Jir8taiwan/ST170_ext.control_IMRC/bypass IMRC detection without usage_2.jpg

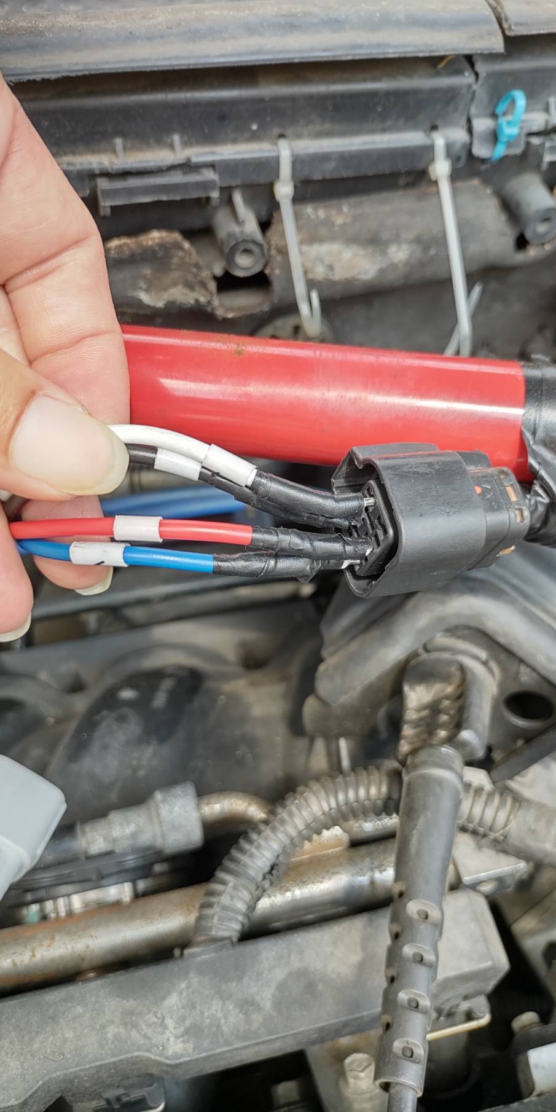
bypass IMRC detection without usage_2.jpg
