Jir8taiwan/ST170_ext.control_IMRC/[planB]_IMRCmod_and_DirectDrive_Motor/IMRC internal modify_2026-06-15.jpg

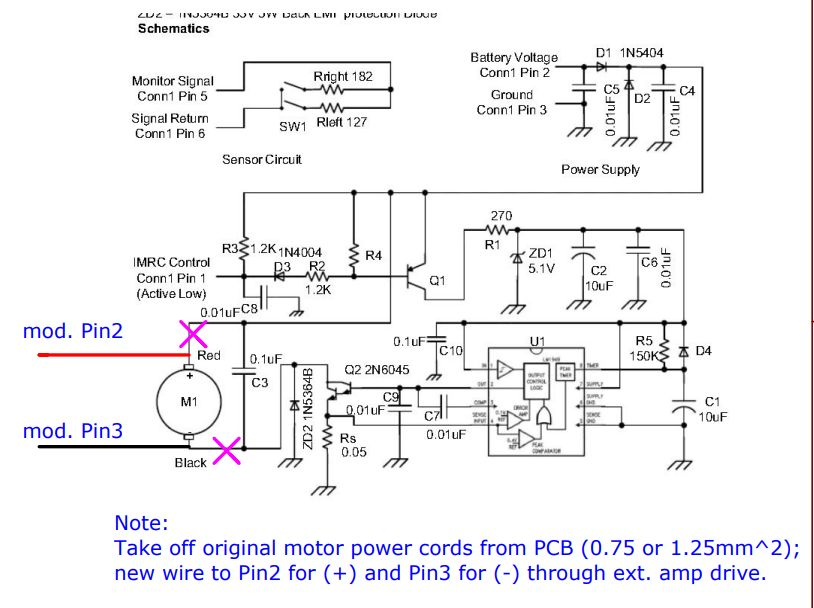
[planB]_IMRCmod_and_DirectDrive_Motor/IMRC internal modify_2026-06-15.jpg
