Jir8taiwan/ST170_ext.control_IMRC/[planB]_IMRCmod_and_DirectDrive_Motor/IMRC_75R硬體開關迴路變電晶體開關迴路_260708.jpg

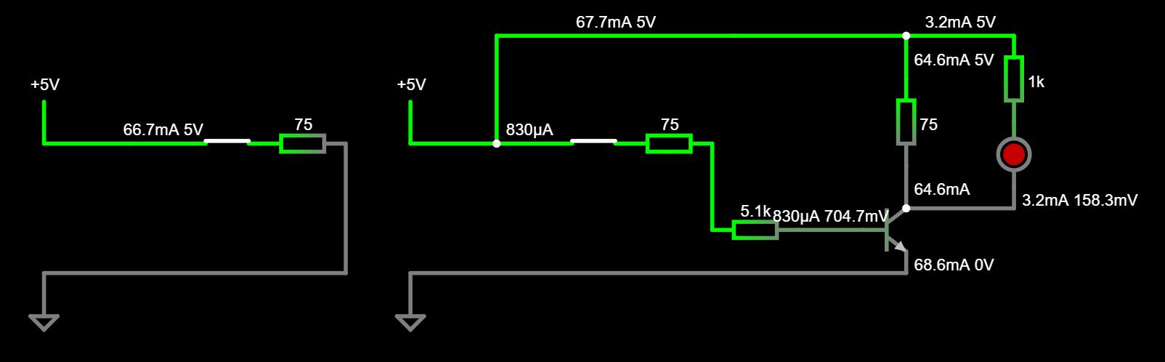
[planB]_IMRCmod_and_DirectDrive_Motor/IMRC_75R硬體開關迴路變電晶體開關迴路_260708.jpg
