Jir8taiwan/ST170_ext.control_IMRC/[planB]_IMRCmod_and_DirectDrive_Motor/IMRC_DirectDrive_by CVCC power source and 5V relay_260105_.jpg

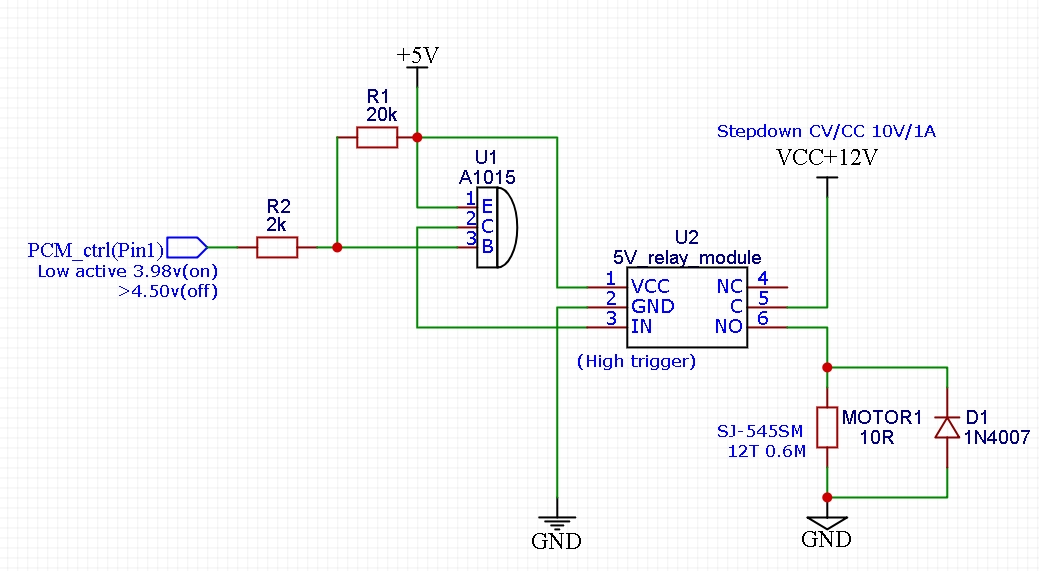
[planB]_IMRCmod_and_DirectDrive_Motor/IMRC_DirectDrive_by CVCC power source and 5V relay_260105_.jpg
