Jir8taiwan/ST170_ext.control_IMRC/[planB]_IMRCmod_and_DirectDrive_Motor/Schematic_IMRCmod_DirectDrive_Motor_2026-07-09.pdf

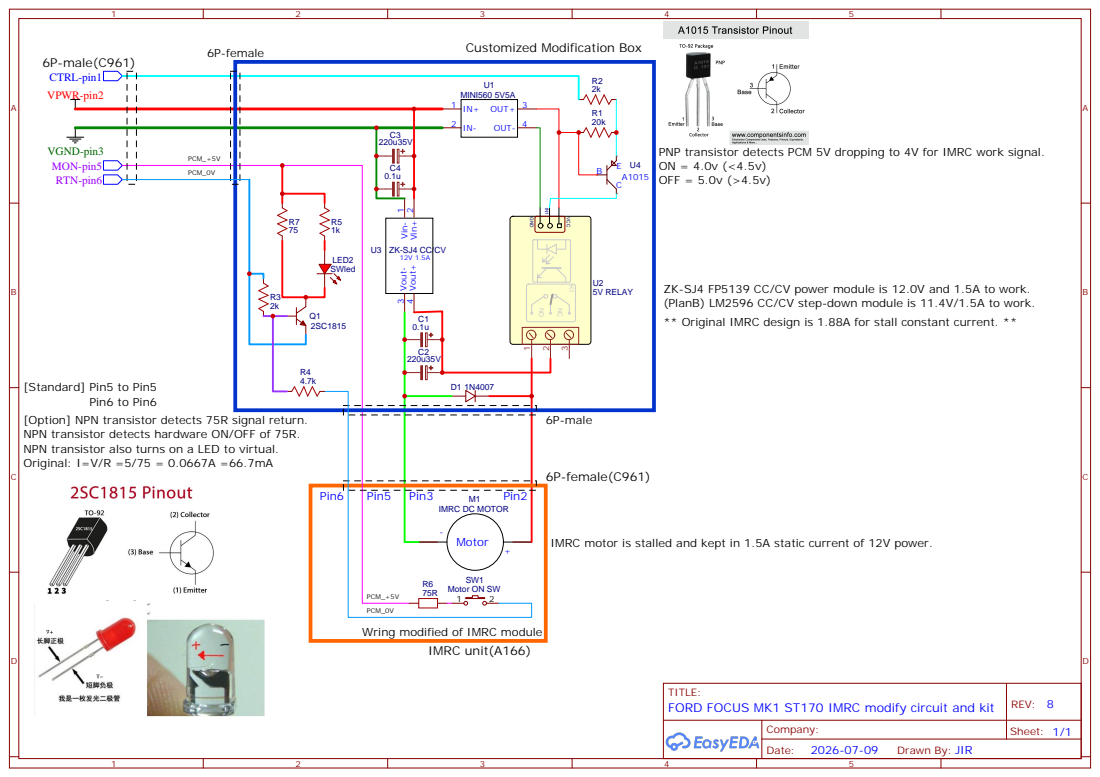
[picture p7: page 1]

U3 ZK-SJ4 CC/CV Vin+

ZK-SJ4 FP5139 CC/CV power module is 12.0V and 1.5A to work.
(PlanB) LM2596 CC/CV step-down module is 11.4V/1.5A to work.
** Original IMRC design is 1.88A for stall constant current. **

[Option] NPN transistor detects 75R signal return.
NPN transistor detects hardware ON/OFF of 75R.
NPN transistor also turns on a LED to virtual.
Original: I=V/R =5/75 = 0.0667A =66.7mA

IMRC motor is stalled and kept in 1.5A static current of 12V power.
