Jir8taiwan/ST170_ext.control_IMRC/[planA]_ArduinoIMRC_DCmotorControl/Schematic_ST170_ext.control_IMRC diagram_2026-06-26.pdf

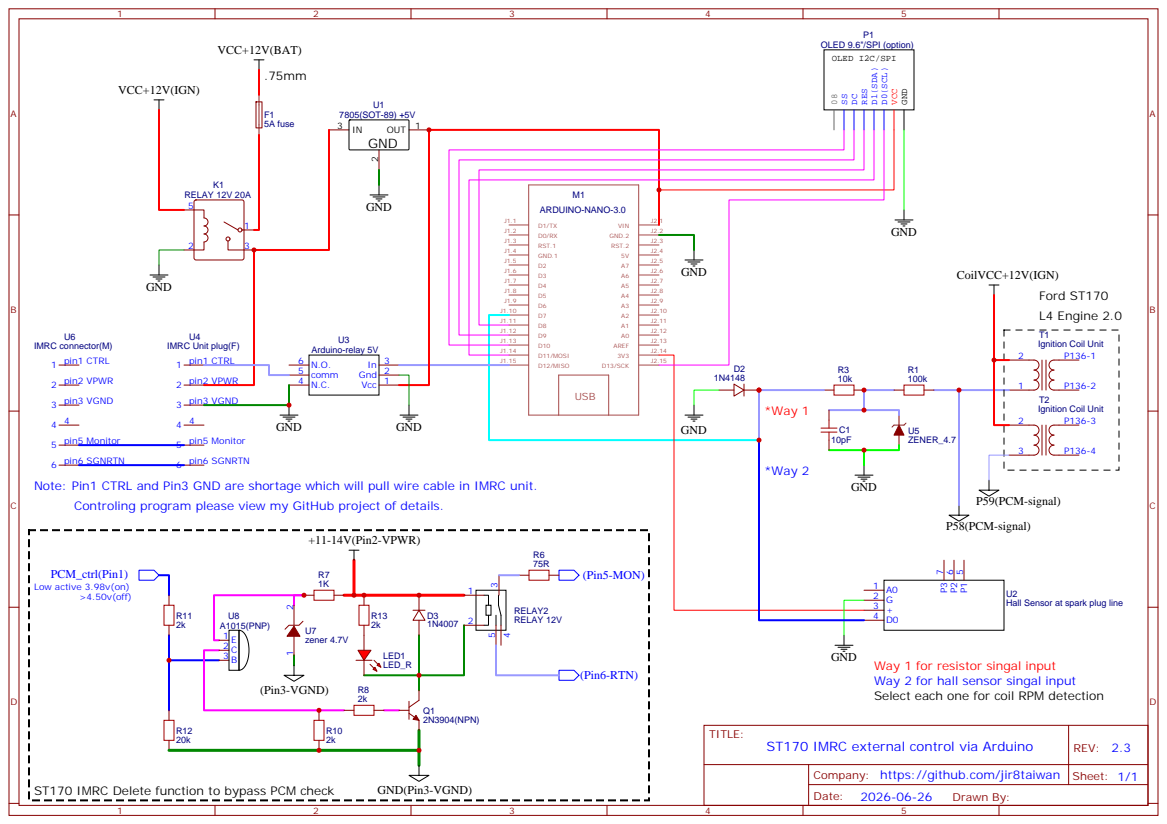
[picture p8: page 1]

Hall Sensor at spark plug line

GND
Way 1 for resistor singal input
Way 2 for hall sensor singal input
Select each one for coil RPM detection

Company: https://github.com/jir8taiwan

ST170 IMRC Delete function to bypass PCM check
