Jir8taiwan/ST170_ext.control_IMRC/[planB]_IMRCmod_and_DirectDrive_Motor/Schematic_IMRCmod_DirectDrive_Motor_2026-06-17.pdf

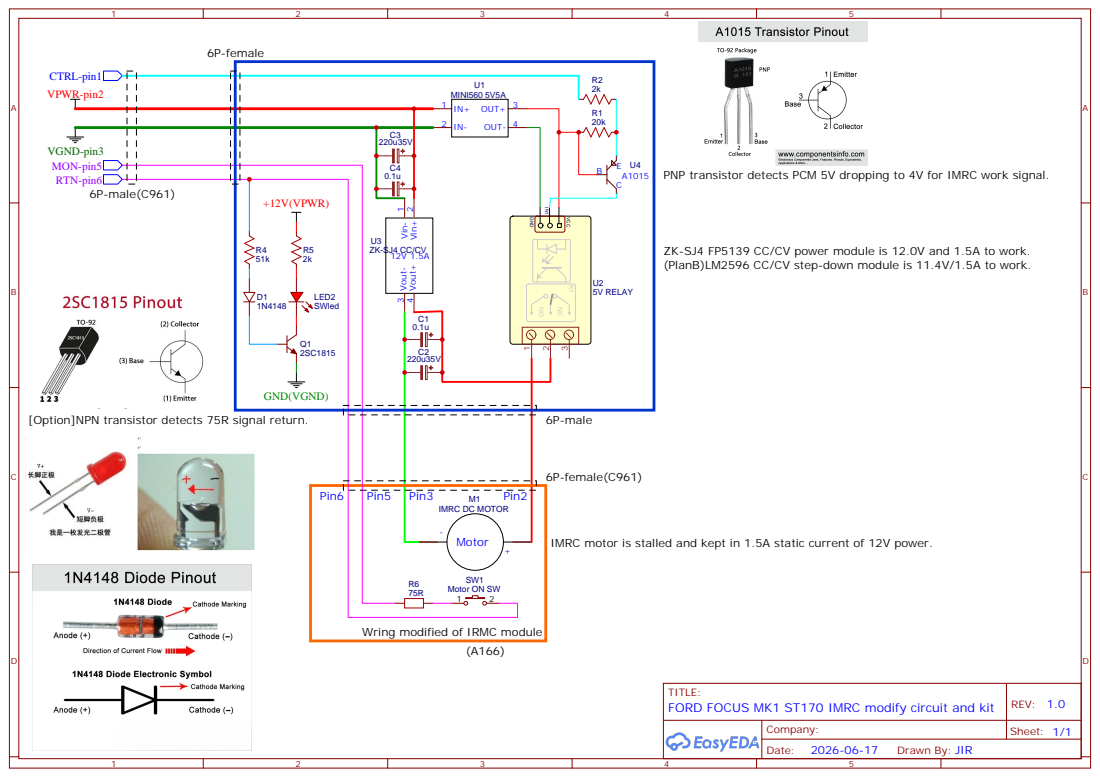
[picture p9: page 1]

PNP transistor detects PCM 5V dropping to 4V for IMRC work signal.

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

[Option]NPN transistor detects 75R signal return.

IMRC motor is stalled and kept in 1.5A static current of 12V power.

Wring modified of IRMC module
