Jir8taiwan/ST170_ext.control_IMRC/[planA]_ArduinoIMRC_DCmotorControl/Schematic_ST170_ext.control_IMRC diagram_251113.pdf

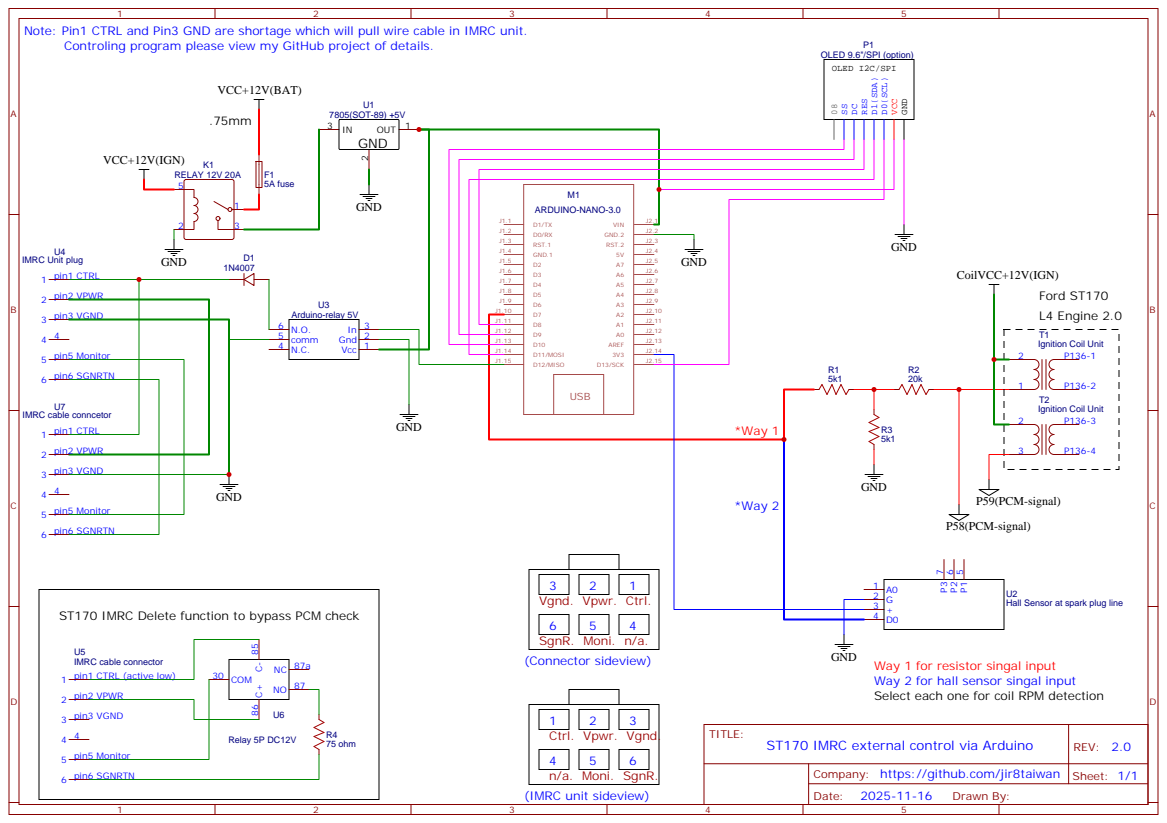
[picture p10: page 1]

Note: Pin1 CTRL and Pin3 GND are shortage which will pull wire cable in IMRC unit.
Controling program please view my GitHub project of details.

Hall Sensor at spark plug line

ST170 IMRC Delete function to bypass PCM check

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

Company: https://github.com/jir8taiwan
