Jir8taiwan/ST170_ext.control_IMRC/[planA]_ArduinoIMRC_DCmotorControl/ArduinoIMRC_DCmotorControl_2025-12-08.pdf

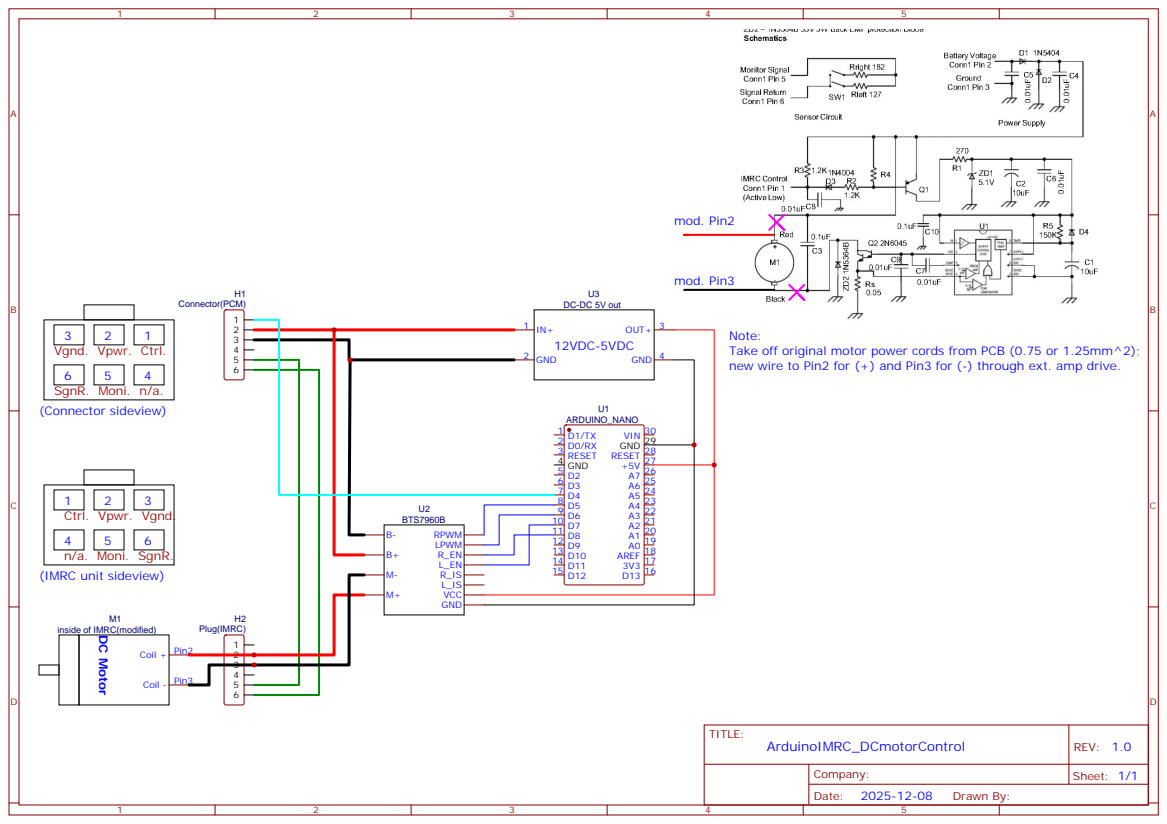
[picture p11: page 1]

Note:
Take off original motor power cords from PCB (0.75 or 1.25mm^2);
new wire to Pin2 for (+) and Pin3 for (-) through ext. amp drive.

inside of IMRC(modified)
