Jir8taiwan/ST170_ext.control_IMRC/Schematic_IMRC_RelayModule_trigger_2026-06-24.pdf

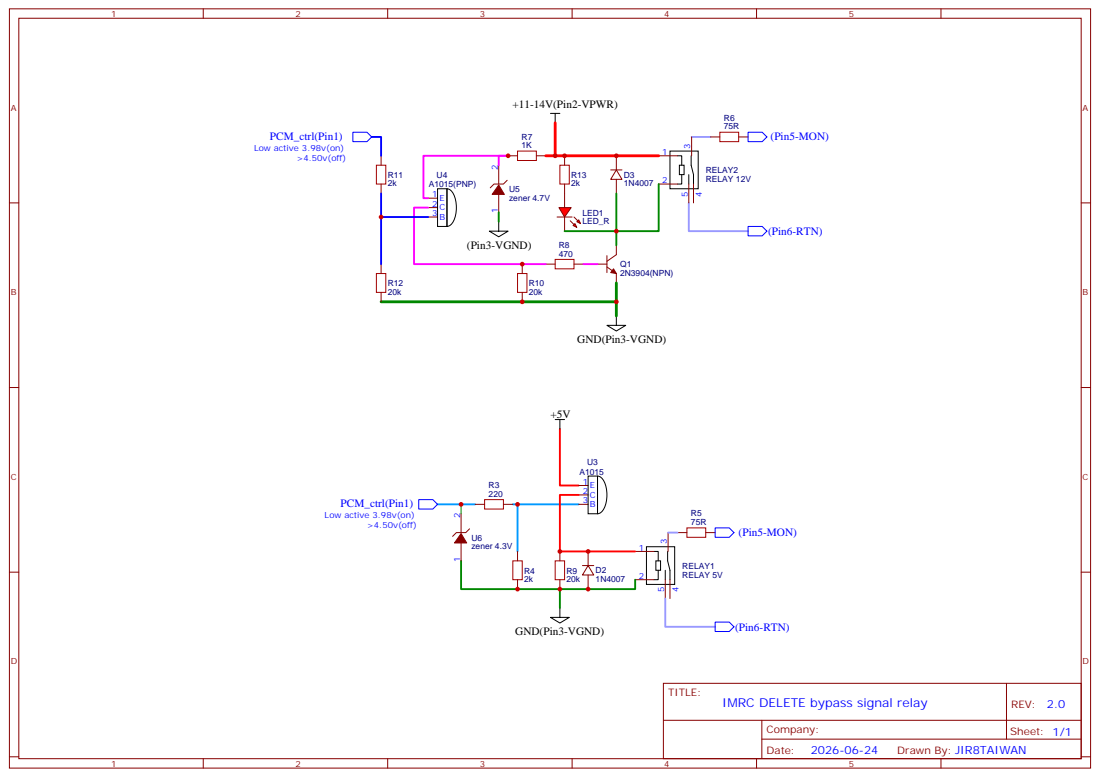
[picture p12: page 1]
