Jir8taiwan/ST170_ext.control_IMRC/Schematic_IMRC_RelayModule_trigger_2026-06-23.pdf

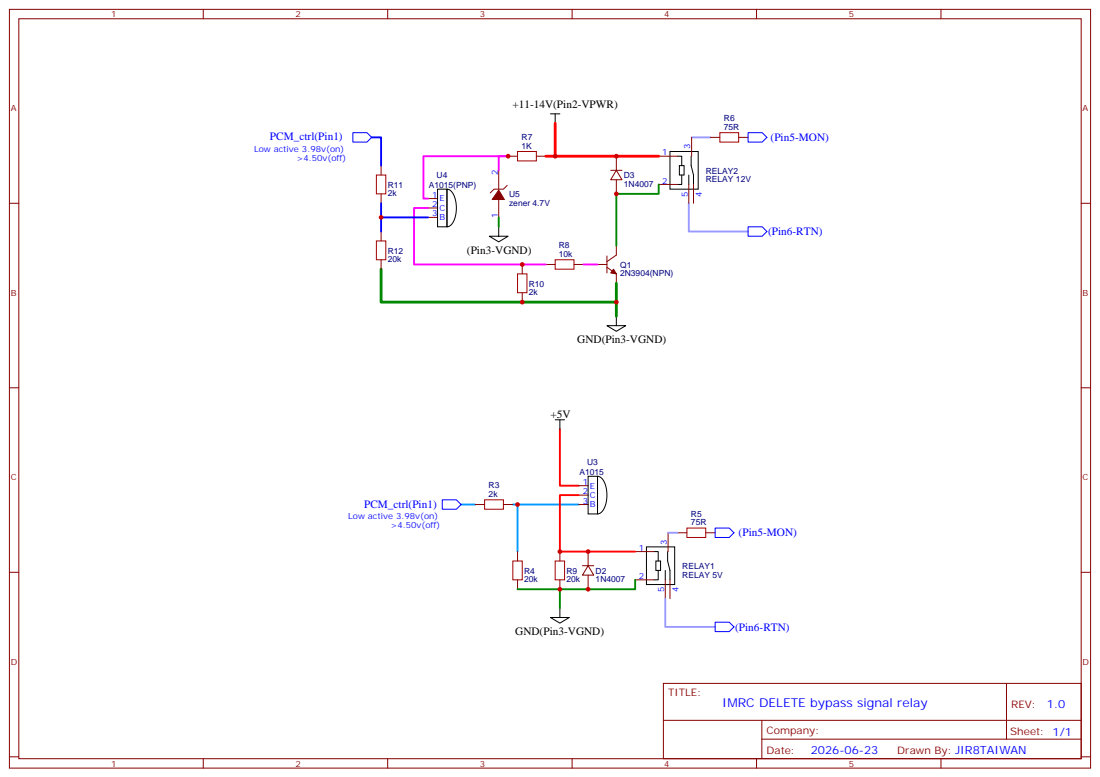
[picture p13: page 1]
