Jir8taiwan/ST170_ext.control_IMRC/(commit log)

2022-03-21 ST170_IMRC_extcontrol_tachometer.ino
    ****** Using Arduino board to control IMRC active signal externally for Ford Focus MK1 ST170
    Version 2.0 in 2022.03.21
    ****** define environment:
    **digital pin 12 is control +5V realy coil
    **digital pin 7 is the hall pin of signal input
2022-07-18 add an OLED I2C display status
2022-07-22 use three resistors for coil signal input
2022-07-23 IMRC unit bypass via 5p relay
    If IMRC is totally broken but want to ignore P1518 error code, it can try this way for key switch on status.
    It needs a 75ohm resistor and a 5p relay to built the cheat way for ecu(PCM).
    When pulled in long-term mode (low rpm), MONITOR pin needs to be cut off in infinity ohm.
    When released in short-term mode (high rpm), MONITOR pin needs to have 75ohm.
2022-07-25 wiring diagram of the idea
2022-07-28 PDF document for wiring connection of details
    ST170_ext.control_IMRC diagram
    PDF format document for reference.
2025-12-08 fix some wiring correction
    1. IMRC female/male connector of pin layout
    2. Delete relay of coil work
2025-12-08 Add files via upload
    Way 2 of plan B, IMRC module uses Arduino Nano and an external DC motor driver to pull inside of the motor and static hold cable by PWM control program from PCM control signal.
2025-12-09 Add files via upload
    IMRC motor wiring modification and run with Arduino kits
2025-12-31 Refactor motor control logic with signal filtering
    Updated motor control parameters and added signal stability filtering.
    [ArduinoIMRC_DCmotorControl_251106.ino]
2026-01-05 Concept: IMRC directly drive modify
    Via S9012 transistor receives PCM low active (5->4V) and provides the signal to drive a 5V relay module.
    The 5V relay module transits path from COM with 12V source to NO for IMRC motor coil+.
    The 12V power source is from CC and CV stepdown module to have a choked 10V and 1A stable supply.
2026-06-15 Directly drive IMRC motor with CC/CV power module
    It uses A1015 PNP transistor to detect Pin1 CTRL (5V to 3.5V) active, and drives 5V relay module to run IMRC motor coil. 12V Power source is controled static energy from FP5139 CC/CV module to setup 12V 1.5A supply after relay building curcuit. External 2SC1815 NPN transistor and LED to detect the 75R signal feedback to PCM about IMRC in long inlet position.
2026-06-15 modify motor power cables
    It must change original circuit to make the IMRC motor which can be powering from external control module.
2026-06-16 IMRC motor modificaiton detail
    Motor coil cables remove and rewire to Pin2(M+) and Pin3(M-) to directly drive. TIP121 can remove while it is broken and use with external driver of my project.
2026-06-17 sorting three kinds of application solutions and circuits.
2026-06-24 Plan A of external arduino circuit is fixred resisters to get rpm from spark coil and whole connection adjustment.
2026-06-26 Arduino detect rpm via spark coil is added 100pF for filter.
2026-06-26 Arduino with OLED display is reviewed program and logical controls.
2026-06-26 Reviewed programs and fixed logical controls.
    [ST170_IMRC_extcontrol_tachometer.ino, ST170_IMRC_extcontrol_tachometer_with_OLED_display.ino]
2026-07-08 75R feedback hardware switch is changed to NPN switch to build circuit with LED visible way.
2026-07-09 NPN of 75R switch is adding a pull-down resistor for stable concern
